dangnelson/WATERBEAR-Water-Barrel/(list of files, cad)

Other CAD files:
Water-Barrel-Model.skp
Water-Barrel-Model~.skp
Waterbarrel-Model.skp
