dangnelson/WATERBEAR-Water-Barrel/(commit log)

2018-12-19 start budget
    [Waterbarrel-Model.skp]
2018-12-23 Add ons
    [Waterbarrel-Model.skp]
2023-03-02 adjust additional barrels image
    [Water-Barrel-Model.skp, Water-Barrel-Model~.skp]
2023-03-11 Move Water Barrel
    [Water-Barrel-Model.skp, Water-Barrel-Model~.skp]
